pa3axa/DAC_PI4_OCXO/Master_OCXO_DAC.jpg

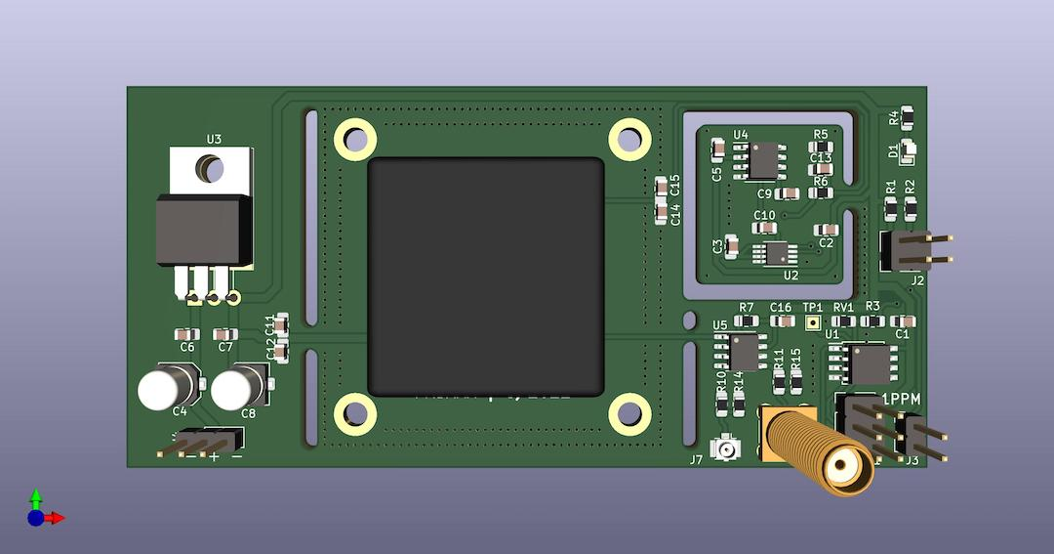
Master_OCXO_DAC.jpg
