pa3axa/DAC_PI4_OCXO/PI4-Decoding.png

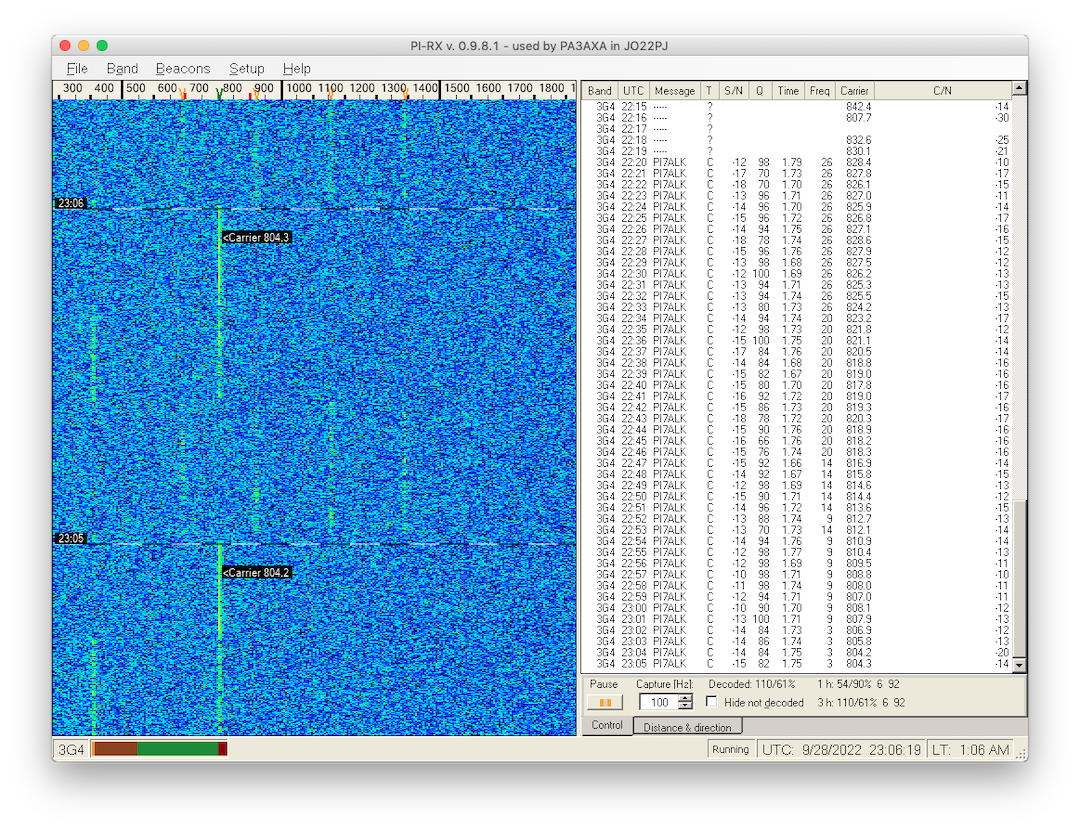
PI4-Decoding.png
