pa3axa/DAC_PI4_OCXO/PI7ALK_OCXO.jpg

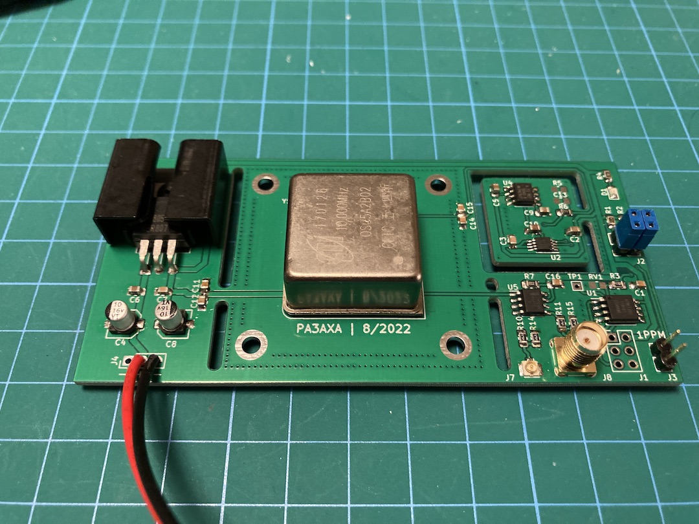
PI7ALK_OCXO.jpg
