pa3axa/DAC_PI4_OCXO/Master_OCXO_DAC_V1.2.xlsx

Designator | Package | Quantity | Designation | Supplier and ref
C13 | C_0805_2012Metric_Pad1.18x1.45mm_HandSolder | 1 | Not placed
C14,C7,C15,C1,C11,C3,C12,C16,C10 | C_0805_2012Metric_Pad1.18x1.45mm_HandSolder | 9 | 100n
C2 | C_0805_2012Metric_Pad1.18x1.45mm_HandSolder | 1 | 4u7
C6 | C_0805_2012Metric_Pad1.18x1.45mm_HandSolder | 1 | 330n
C8,C4 | C_Elec_5x5.4 | 2 | 10u
C9,C5 | C_0805_2012Metric_Pad1.18x1.45mm_HandSolder | 1 | 1u
C10 | C_0805_2012Metric_Pad1.18x1.45mm_HandSolder | 1 | 22u
D1 | LED_0805_2012Metric_Pad1.15x1.40mm_HandSolder | 1 | LED
J1 | PinHeader_2x03_P2.54mm_Vertical | 1 | AVR-ISP-6
J2 | PinHeader_2x02_P2.54mm_Vertical | 1 | EXT I2C
J3 | PinHeader_1x02_P2.54mm_Vertical | 1 | Conn_01x02_Male
J4 | PinHeader_1x03_P2.54mm_Vertical | 1 | Conn_01x03_Male
J7 | U.FL_Hirose_U.FL-R-SMT-1_Vertical | 1 |  | Ebay/AliExpress
J8 | SMA_Amphenol_901-144_Vertical | 1 |  | Ebay/AliExpress
R14,R15,R10,R11 | R_0805_2012Metric_Pad1.20x1.40mm_HandSolder | 4 | 49.9
R2,R1 | R_0805_2012Metric_Pad1.20x1.40mm_HandSolder | 2 | 4k7
R3 | R_0805_2012Metric_Pad1.20x1.40mm_HandSolder | 1 | 470
R4,R7 | R_0805_2012Metric_Pad1.20x1.40mm_HandSolder | 2 | 10k
R5 | R_0805_2012Metric_Pad1.20x1.40mm_HandSolder | 1 | 270
R6 | R_0805_2012Metric_Pad1.20x1.40mm_HandSolder | 2 | Not placed
RV1 | R_0805_2012Metric_Pad1.20x1.40mm_HandSolder | 1 | 5V
TP1 | TestPoint_THTPad_1.5x1.5mm_Drill0.7mm | 1 | TestPoint
U1 | SOIC-8W_5.3x5.3mm_P1.27mm | 1 | ATtiny85-20S
U2 | MSOP-8_3x3mm_P0.65mm | 1 | MAX5217
U3 | TO-220-3_Horizontal_TabDown | 1 | LM7805
U4 | SOIC-8_3.9x4.9mm_P1.27mm | 1 | REF5040
U5 | SOIC-8_3.9x4.9mm_P1.27mm | 1 | NB3N551
Y1 | CTI-OSC5A2B | 1 | CTI 10Mhz | Ebay/AliExpress
