pa3axa/DAC_PI4_OCXO/Master_OCXO_DAC_V1.2.sch.pdf

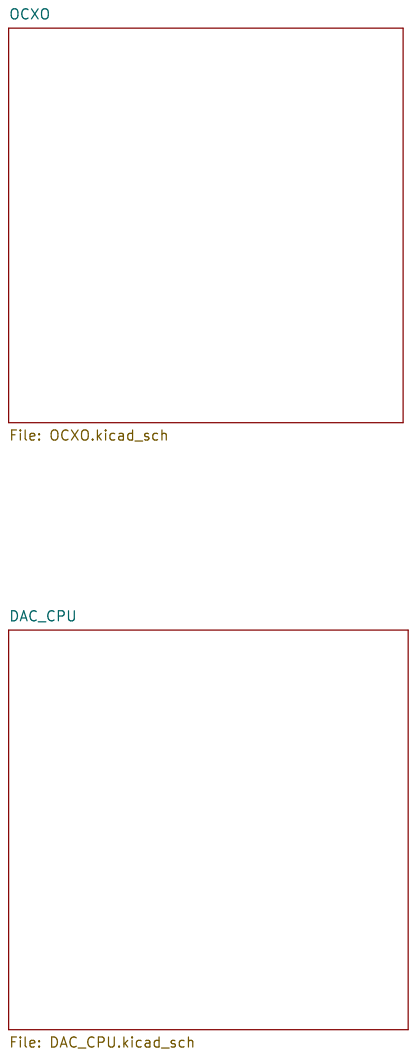
[picture p4: page 1]

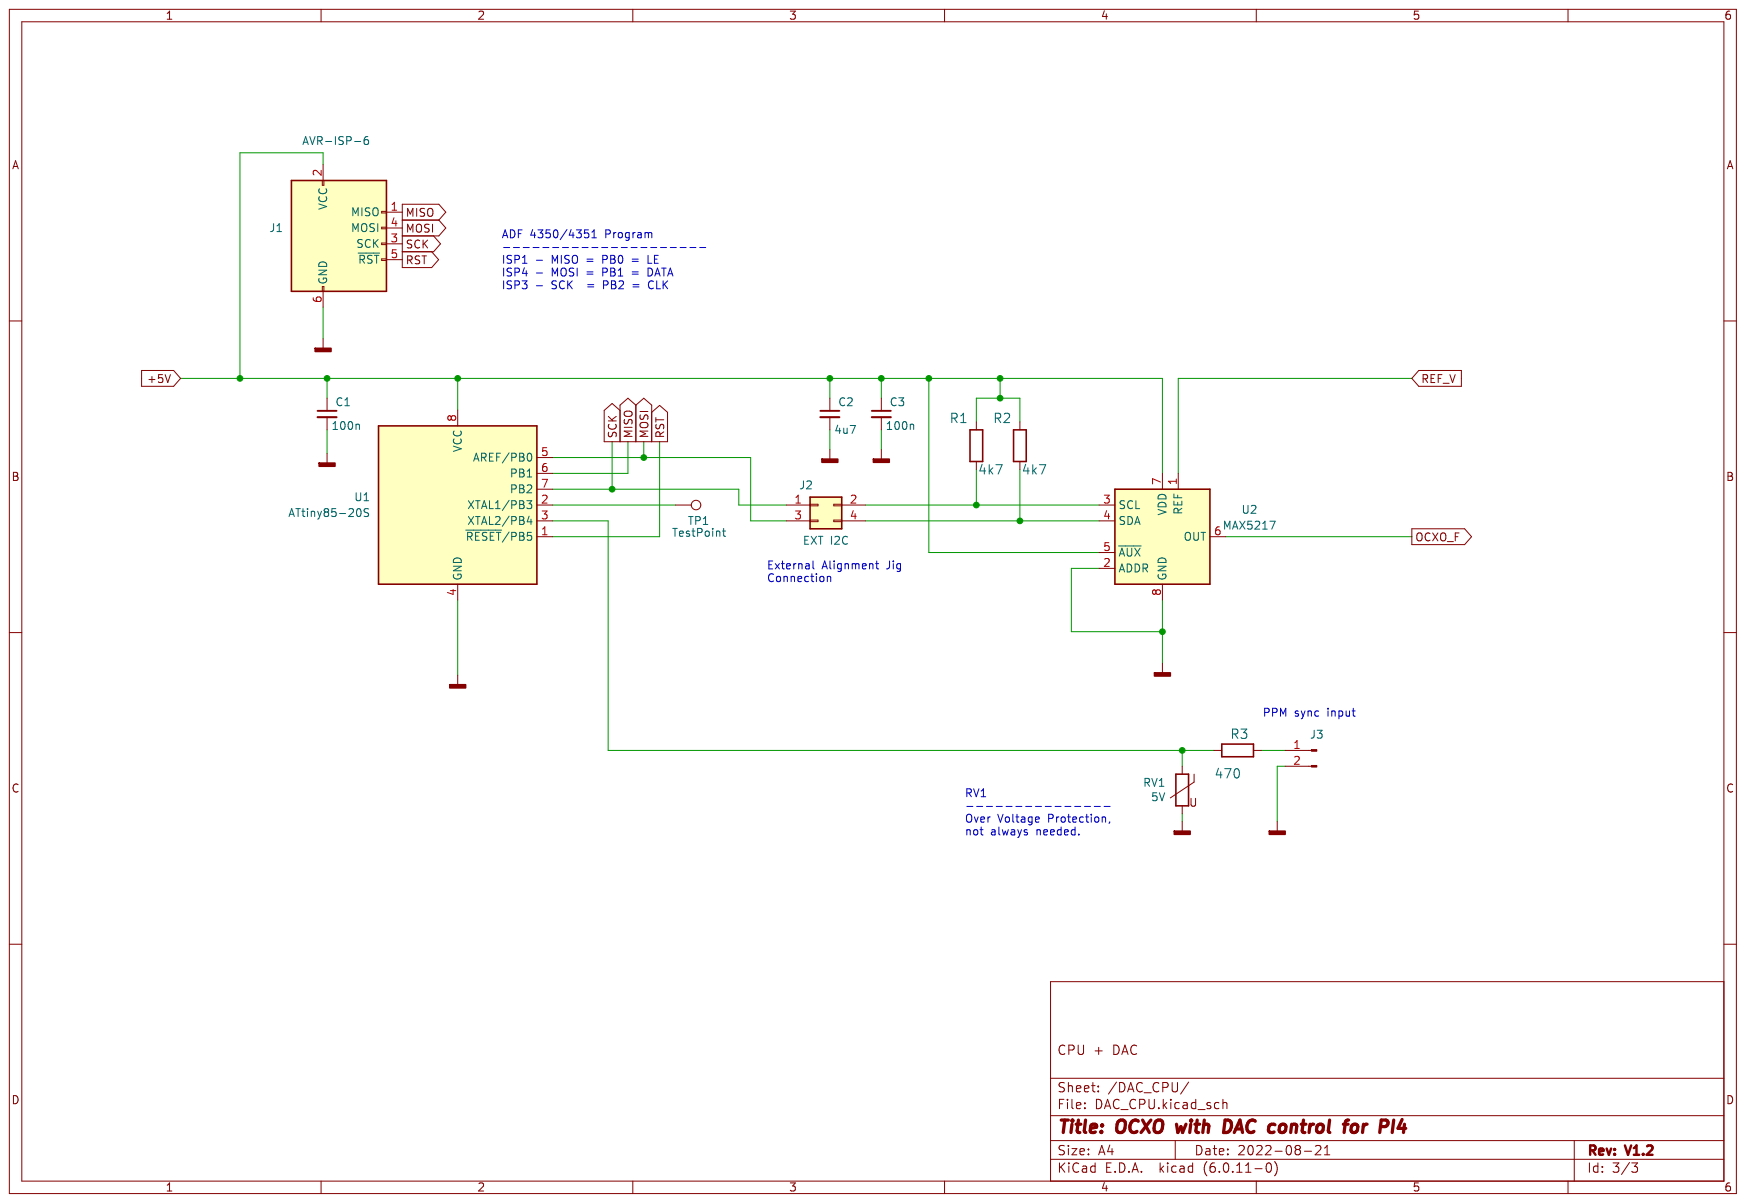
[picture p5: page 2]

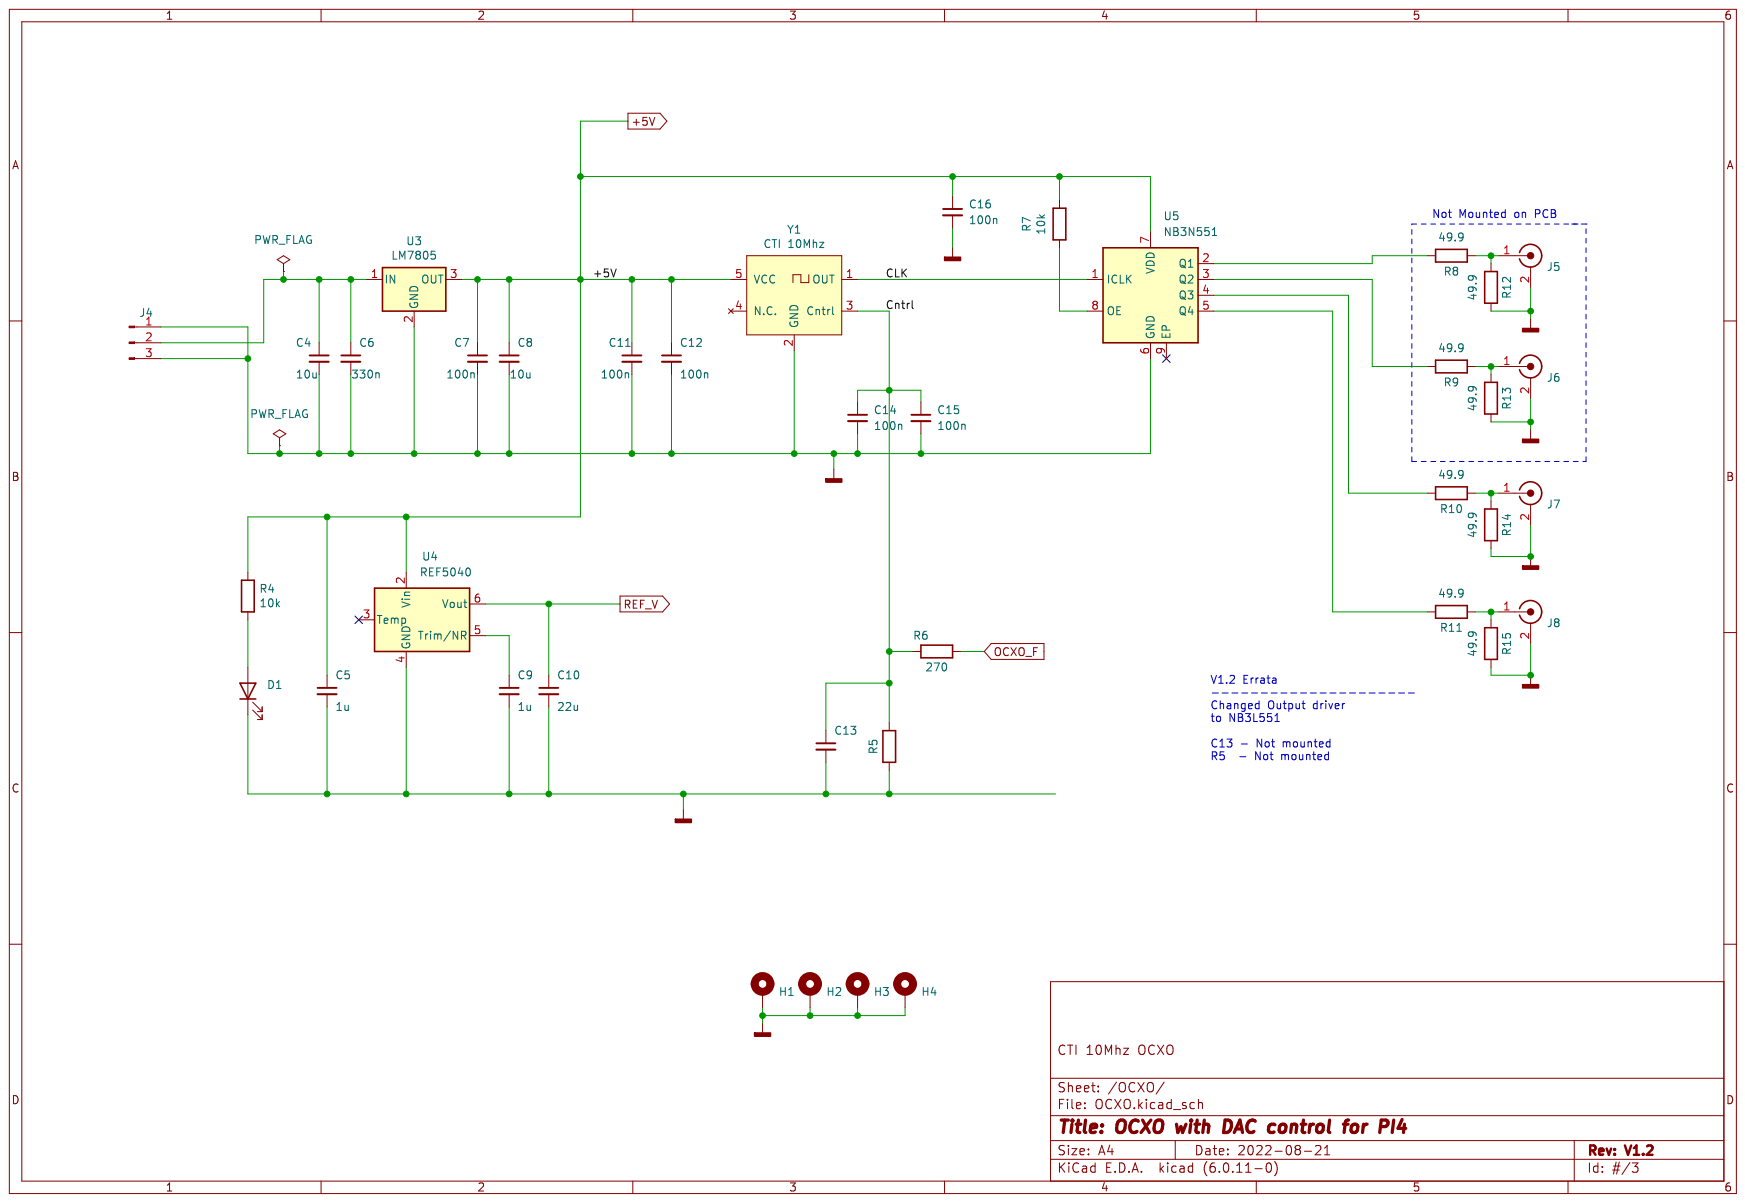
[picture p6: page 3]
