pa3axa/DAC_PI4_OCXO/(commit log)

2022-08-31 Update PCB Picture
2022-09-28 create BOM file
    [Master_OCXO_DAC_V1.0.xlsx]
2022-11-23 Added software
    [Master_OCXO_DAC_V1.0.xlsx]
2022-11-28 Component Values Updated
    [Master_OCXO_DAC_V1.0.xlsx, Master_OCXO_DAC_V1.2.xlsx]
